chuechcon1132005-max/FreeRTOS-based-STM32-Data-Logger-with-LCD-Touch-UI/Core/Inc/main.h

#define LCD_RST_Pin GPIO_PIN_2
#define LCD_RST_GPIO_Port GPIOB
#define TP_IRQ_Pin GPIO_PIN_4
#define TP_IRQ_GPIO_Port GPIOB
#define LCD_BKL_Pin GPIO_PIN_6
#define LCD_BKL_GPIO_Port GPIOB
#define LCD_CS_Pin GPIO_PIN_7
#define LCD_CS_GPIO_Port GPIOB
#define LCD_DC_Pin GPIO_PIN_8
#define LCD_DC_GPIO_Port GPIOB
#define TP_CS_Pin GPIO_PIN_9
#define TP_CS_GPIO_Port GPIOB
