chuechcon1132005-max/FreeRTOS-based-STM32-Data-Logger-with-LCD-Touch-UI/LCD28/LCD_Driver.c

/*****************************************************************************
* | File      	:		LCD_Driver.c
* | Author      :   Waveshare team
* | Function    :   LCD_Driver driver of ST7789 & HX8347
* | Info        :
*----------------
* |	This version:   V1.2
* | Date        :   2019-08-16
* | Info        :
#
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
******************************************************************************/

#include "LCD_Driver.h"
#include "LCD_lib.h"
#include "math.h"
#include <stdlib.h>

extern SPI_HandleTypeDef hspi1;

#define LCD_SPI_BURST_PIXELS 64u

void lcd_write_byte(uint8_t chByte, uint8_t chCmd);

static void lcd_set_window_st7789(uint16_t x0, uint16_t y0, uint16_t x1, uint16_t y1)
{
	lcd_write_byte(0x2A, LCD_CMD);
	lcd_write_byte((uint8_t)(x0 >> 8), LCD_DATA);
	lcd_write_byte((uint8_t)(x0 & 0xFF), LCD_DATA);
	lcd_write_byte((uint8_t)(x1 >> 8), LCD_DATA);
	lcd_write_byte((uint8_t)(x1 & 0xFF), LCD_DATA);

	lcd_write_byte(0x2B, LCD_CMD);
	lcd_write_byte((uint8_t)(y0 >> 8), LCD_DATA);
	lcd_write_byte((uint8_t)(y0 & 0xFF), LCD_DATA);
	lcd_write_byte((uint8_t)(y1 >> 8), LCD_DATA);
	lcd_write_byte((uint8_t)(y1 & 0xFF), LCD_DATA);

	lcd_write_byte(0x2C, LCD_CMD);
}

static void lcd_push_color_st7789(uint16_t hwColor, uint32_t pixels)
{
	uint8_t burst[LCD_SPI_BURST_PIXELS * 2u];
	uint32_t i;

	for (i = 0; i < LCD_SPI_BURST_PIXELS; i++) {
		burst[(2u * i)] = (uint8_t)(hwColor >> 8);
		burst[(2u * i) + 1u] = (uint8_t)(hwColor & 0xFF);
	}

	LCD_DC_H();
	LCD_CS_L();
	while (pixels > 0u) {
		uint16_t chunk_pixels = (pixels > LCD_SPI_BURST_PIXELS) ? LCD_SPI_BURST_PIXELS : (uint16_t)pixels;
		(void)HAL_SPI_Transmit(&hspi1, burst, (uint16_t)(chunk_pixels * 2u), HAL_MAX_DELAY);
		pixels -= chunk_pixels;
	}
	LCD_CS_H();
}

/******************************************************************************
function :	initial SPI1
parameter:
******************************************************************************/
void spi_init(void)
{
	/* SPI1 is configured by MX_SPI1_Init() in main.c */
}

/******************************************************************************
function :	SPI1 send data
parameter:
send_char:	sned data
******************************************************************************/
uint8_t spi1_communication(uint8_t send_char)
{
	uint8_t rx = 0;
	if (HAL_SPI_TransmitReceive(&hspi1, &send_char, &rx, 1, HAL_MAX_DELAY) != HAL_OK) {
		return 0;
	}
	return rx;
}

/******************************************************************************
function :	write eight bits' data to LCD
parameter:
  chByte : send data
  chCmd  : command or data
******************************************************************************/
void lcd_write_byte(uint8_t chByte, uint8_t chCmd)
{
    if (chCmd) {
        LCD_DC_H();
    } else {
        LCD_DC_L();
    }
    
    LCD_CS_L();
    spi1_communication(chByte);
    LCD_CS_H();
}

/******************************************************************************
function :	write sixteen bits' data to LCD
parameter:
  chByte : send data
  chCmd  : command or data
******************************************************************************/
void lcd_write_word(uint16_t hwData)
{
    LCD_DC_H();
    LCD_CS_L();
    spi1_communication(hwData >> 8);
    spi1_communication(hwData & 0xFF);
    LCD_CS_H();
}

/******************************************************************************
function :	write data to LCD register
parameter:
     chByte : send data
		 chCmd  : command or data
******************************************************************************/
void lcd_write_command(uint8_t chRegister, uint8_t chValue)
{
	lcd_write_byte(chRegister, LCD_CMD);
	lcd_write_byte(chValue, LCD_DATA);
}

/********************************************************************************
Function Name  : initials lcd control pin 
			parameter:
********************************************************************************/
void lcd_ctrl_port_init(void)
{
	/* GPIOs are configured by MX_GPIO_Init() in main.c */
}

/******************************************************************************
Function Name  : delay
			parameter: ms
******************************************************************************/
void delay_ms(uint32_t ms)
{
	HAL_Delay(ms);
}

/******************************************************************************
Function Name  : initials lcd control pin 
			parameter:
******************************************************************************/
void lcd_init(void)
{
  lcd_ctrl_port_init();
	LCD_RST_H();
  spi_init();
	
	LCD_CS_H();
	LCD_BKL_H();
#ifdef 	ST7789_DEVICE
	LCD_RST_H();
	delay_ms(5);
	LCD_RST_L();
	delay_ms(5);
	LCD_RST_H();
	delay_ms(5);
	LCD_CS_H();
#endif
	
#ifdef HX8347D_DEVICE	
	lcd_write_command(0xEA,0x00);
	lcd_write_command(0xEB,0x20);
	lcd_write_command(0xEC,0x0C);
	lcd_write_command(0xED,0xC4);
	lcd_write_command(0xE8,0x38);
	lcd_write_command(0xE9,0x10);
	lcd_write_command(0xF1,0x01);
	lcd_write_command(0xF2,0x10);
	lcd_write_command(0x40,0x01); 
	lcd_write_command(0x41,0x00); 
	lcd_write_command(0x42,0x00); 
	lcd_write_command(0x43,0x10); 
	lcd_write_command(0x44,0x0E); 
	lcd_write_command(0x45,0x24); 
	lcd_write_command(0x46,0x04); 
	lcd_write_command(0x47,0x50); 
	lcd_write_command(0x48,0x02); 
	lcd_write_command(0x49,0x13); 
	lcd_write_command(0x4A,0x19); 
	lcd_write_command(0x4B,0x19); 
	lcd_write_command(0x4C,0x16); 
	lcd_write_command(0x50,0x1B); 
	lcd_write_command(0x51,0x31); 
	lcd_write_command(0x52,0x2F); 
	lcd_write_command(0x53,0x3F); 
	lcd_write_command(0x54,0x3F); 
	lcd_write_command(0x55,0x3E); 
	lcd_write_command(0x56,0x2F); 
	lcd_write_command(0x57,0x7B); 
	lcd_write_command(0x58,0x09); 
	lcd_write_command(0x59,0x06); 
	lcd_write_command(0x5A,0x06); 
	lcd_write_command(0x5B,0x0C); 
	lcd_write_command(0x5C,0x1D); 
	lcd_write_command(0x5D,0xCC); 
	lcd_write_command(0x1B,0x1B);
	lcd_write_command(0x1A,0x01);
	lcd_write_command(0x24,0x2F);
	lcd_write_command(0x25,0x57);
	lcd_write_command(0x23,0x88);
	lcd_write_command(0x18,0x34);
	lcd_write_command(0x19,0x01);
	lcd_write_command(0x01,0x00);
	lcd_write_command(0x1F,0x88);
	lcd_write_command(0x1F,0x80);
	lcd_write_command(0x1F,0x90);
	lcd_write_command(0x1F,0xD0);
	lcd_write_command(0x17,0x05); 
	lcd_write_command(0x36,0x02); 
	lcd_write_command(0x28,0x38);
	lcd_write_command(0x28,0x3F);
	lcd_write_command(0x16,0x18); 
	lcd_write_command(0x02,0x00);
	lcd_write_command(0x03,0x00);
	lcd_write_command(0x04,0x00);
	lcd_write_command(0x05,0xEF);
	lcd_write_command(0x06,0x00);
	lcd_write_command(0x07,0x00);
	lcd_write_command(0x08,0x01);
	lcd_write_command(0x09,0x3F);
	
#elif defined ST7789_DEVICE
	lcd_write_byte(0x11,LCD_CMD);
	delay_ms(10);
	lcd_write_command(0x36,0x00);
	lcd_write_command(0x3a,0x05);
	lcd_write_byte(0xb2,LCD_CMD);
	lcd_write_byte(0x0c,LCD_DATA);
	lcd_write_byte(0x0c,LCD_DATA);
	lcd_write_byte(0x00,LCD_DATA);
	lcd_write_byte(0x33,LCD_DATA);
	lcd_write_byte(0x33,LCD_DATA);
	lcd_write_command(0xb7,0x35);
	lcd_write_command(0xbb,0x28);
	lcd_write_command(0xc0,0x3c);
	lcd_write_command(0xc2,0x01);
	lcd_write_command(0xc3,0x0b);
	lcd_write_command(0xc4,0x20);
	lcd_write_command(0xc6,0x0f);
	lcd_write_byte(0xD0,LCD_CMD);
	lcd_write_byte(0xa4,LCD_DATA);
	lcd_write_byte(0xa1,LCD_DATA);
	lcd_write_byte(0xe0,LCD_CMD);
	lcd_write_byte(0xd0,LCD_DATA);
	lcd_write_byte(0x01,LCD_DATA);
	lcd_write_byte(0x08,LCD_DATA);
	lcd_write_byte(0x0f,LCD_DATA);
	lcd_write_byte(0x11,LCD_DATA);
	lcd_write_byte(0x2a,LCD_DATA);
	lcd_write_byte(0x36,LCD_DATA);
	lcd_write_byte(0x55,LCD_DATA);
	lcd_write_byte(0x44,LCD_DATA);
	lcd_write_byte(0x3a,LCD_DATA);
	lcd_write_byte(0x0b,LCD_DATA);
	lcd_write_byte(0x06,LCD_DATA);
	lcd_write_byte(0x11,LCD_DATA);
	lcd_write_byte(0x20,LCD_DATA);
	lcd_write_byte(0xe1,LCD_CMD);
	lcd_write_byte(0xd0,LCD_DATA);
	lcd_write_byte(0x02,LCD_DATA);
	lcd_write_byte(0x07,LCD_DATA);
	lcd_write_byte(0x0a,LCD_DATA);
	lcd_write_byte(0x0b,LCD_DATA);
	lcd_write_byte(0x18,LCD_DATA);
	lcd_write_byte(0x34,LCD_DATA);
	lcd_write_byte(0x43,LCD_DATA);
	lcd_write_byte(0x4a,LCD_DATA);
	lcd_write_byte(0x2b,LCD_DATA);
	lcd_write_byte(0x1b,LCD_DATA);
	lcd_write_byte(0x1c,LCD_DATA);
	lcd_write_byte(0x22,LCD_DATA);
	lcd_write_byte(0x1f,LCD_DATA);
	lcd_write_byte(0x29,LCD_CMD);
	lcd_write_command(0x51,0xff);
	lcd_write_command(0x55,0xB0);
#endif

	lcd_clear_screen(WHITE);
}

/******************************************************************************
Function Name  : clear lcd screen
			parameter:
				hwColor: background color
******************************************************************************/
void lcd_clear_screen(uint16_t hwColor)
{
	uint32_t i, wCount = LCD_WIDTH;
	wCount *= LCD_HEIGHT;

#ifdef ST7789_DEVICE
	lcd_set_window_st7789(0u, 0u, (uint16_t)(LCD_WIDTH - 1u), (uint16_t)(LCD_HEIGHT - 1u));
	lcd_push_color_st7789(hwColor, wCount);
	return;
#endif

#ifdef HX8347D_DEVICE
	lcd_set_cursor(0, 0);
	lcd_write_byte(0x22, LCD_CMD);
#endif
	LCD_CS_L();	
	LCD_DC_H();
	for(i=0;i<wCount;i++){
#ifdef HX8347D_DEVICE
//		spi1_communication((uint8_t)(hwColor&0xff));
//		spi1_communication(hwColor>>8);
		
		spi1_communication(hwColor>>8);
		spi1_communication((uint8_t)(hwColor&0xff));
#elif defined ST7789_DEVICE
		spi1_communication(hwColor>>8);
		spi1_communication((uint8_t)(hwColor&0xff));
#endif
	}
	LCD_CS_H();	
}

/******************************************************************************
Function Name  : set lcd cursor
			parameter:
				 hwXpos: x axis position
				 hwYpos: y axis position
******************************************************************************/
void lcd_set_cursor(uint16_t hwXpos, uint16_t hwYpos)
{
	if (hwXpos >= LCD_WIDTH || hwYpos >= LCD_HEIGHT) {
		return;
	}
#ifdef HX8347D_DEVICE
	lcd_write_command(0x02, hwXpos >> 8);
	lcd_write_command(0x03, hwXpos & 0xFF); 
	lcd_write_command(0x06, hwYpos >> 8);
	lcd_write_command(0x07, hwYpos & 0xFF); 
#elif defined ST7789_DEVICE
	lcd_write_byte(0x2A,LCD_CMD);
	lcd_write_byte(0x00,LCD_DATA);
	lcd_write_byte(hwXpos,LCD_DATA);
	lcd_write_byte(0x2B,LCD_CMD);
	lcd_write_byte((hwYpos>>8)&0xff,LCD_DATA);
	lcd_write_byte(hwYpos&0xff,LCD_DATA);	
#endif
}

/******************************************************************************
Function Name  : lcd display char
			parameter:
				 hwXpos: x axis position
				 hwYpos: y axis position
				  chChr: display character
				 chSize: character size
			  hwColor: character color
******************************************************************************/
void lcd_display_char(	 uint16_t hwXpos, 
                         uint16_t hwYpos, 
                         uint8_t chChr,   
                         uint8_t chSize,  
                         uint16_t hwColor)
{      	
	uint8_t i, j, chTemp = 0;
	uint16_t hwYpos0 = hwYpos, hwColorVal = 0;

	if (hwXpos >= LCD_WIDTH || hwYpos >= LCD_HEIGHT) {
		return;
	}
#ifdef HX8347D_DEVICE
	
#elif defined ST7789_DEVICE
	lcd_write_byte(0x2A,LCD_CMD);
	lcd_write_byte(0x00,LCD_DATA);
	lcd_write_byte(hwXpos,LCD_DATA);
	lcd_write_byte((hwXpos) >> 8,LCD_DATA);
	lcd_write_byte((hwXpos) & 0xFF,LCD_DATA);

	lcd_write_byte(0x2B,LCD_CMD);
	lcd_write_byte(hwYpos >> 8,LCD_DATA);
	lcd_write_byte(hwYpos & 0xFF,LCD_DATA);
	lcd_write_byte((hwYpos) >> 8,LCD_DATA);
	lcd_write_byte((hwYpos) & 0xFF,LCD_DATA);
	lcd_write_byte(0x2C, LCD_CMD);
#endif
    for (i = 0; i < chSize; i ++) {
				if (FONT_1206 == chSize) {
					chTemp = c_chFont1206[chChr - 0x20][i];  
				}
				else if (FONT_1608 == chSize) { 
					chTemp = c_chFont1608[chChr - 0x20][i];
				}			
        for (j = 0; j < 8; j ++) {
					if (chTemp & 0x80) {
						hwColorVal = hwColor;
						lcd_draw_dot(hwXpos, hwYpos, hwColorVal);
					}			
					chTemp <<= 1;
					hwYpos ++;
					if ((hwYpos - hwYpos0) == chSize) {
						hwYpos = hwYpos0;
						hwXpos ++;
						break;
					}
				}  	 
    } 
}
/******************************************************************************
Function Name  : lcd display string
			parameter:
				 hwXpos: x axis position
				 hwYpos: y axis position
		  pchString: display string
				 chSize: string size
			  hwColor: string color
******************************************************************************/
void lcd_display_string(	uint16_t hwXpos,uint16_t hwYpos,
													const uint8_t *pchString,
													uint8_t chSize,uint16_t hwColor)
{

	if (hwXpos >= LCD_WIDTH || hwYpos >= LCD_HEIGHT) {
		return;
	}
	
    while (*pchString != '\0') {       
        if (hwXpos > (LCD_WIDTH - chSize / 2)) {
					hwXpos = 0;
					hwYpos += chSize;
					if (hwYpos > (LCD_HEIGHT - chSize)) {
						hwYpos = hwXpos = 0;
						lcd_clear_screen(0x00);
					}
				}
		
        lcd_display_char(hwXpos, hwYpos, (uint8_t)*pchString, chSize, hwColor);
        hwXpos += chSize / 2;
        pchString ++;
    } 
}

/******************************************************************************
Function Name  : lcd display chinese character
			parameter:
						 gb:	which character in GB2312[][32] 
	  color_front:	character color
				 hwXpos: x axis position
				 hwYpos: y axis position
******************************************************************************/
void lcd_display_GB2312(  uint8_t gb, uint16_t color_front, 
													uint16_t postion_x,uint16_t postion_y )
{
	uint8_t i, j,chTemp;
	uint16_t hwYpos0 = postion_y, hwColorVal = 0;
	
	if (postion_x >= LCD_WIDTH || postion_y >= LCD_HEIGHT) {
		return;
	}
	
	for (i = 0; i < 32; i++) {
		chTemp = GB2312[gb][i];
		for (j = 0; j < 8; j++) {
			if (chTemp & 0x80) {
					hwColorVal = color_front;
				if(i<15)
					lcd_draw_dot(postion_x, postion_y, hwColorVal);
				else
					lcd_draw_dot(postion_x-16, postion_y+8, hwColorVal);
			}
			chTemp <<= 1;
			postion_y ++;
			if ((postion_y - hwYpos0) == 8) {
				postion_y = hwYpos0;
				postion_x ++;
				break;
			}
		}
	}
}

/******************************************************************************
Function Name  : lcd draw a dot
			parameter:
				 hwXpos: x axis position
				 hwYpos: y axis position
				hwColor:	dot color
******************************************************************************/
void lcd_draw_dot(uint16_t hwXpos, uint16_t hwYpos, uint16_t hwColor)
{
	if (hwXpos >= LCD_WIDTH || hwYpos >= LCD_HEIGHT) {
		return;
	}
	lcd_set_cursor(hwXpos, hwYpos);
#ifdef HX8347D_DEVICE
	lcd_write_byte(0x22, LCD_CMD);
#elif defined ST7789_DEVICE
	lcd_write_byte(0x2C, LCD_CMD);
#endif
	lcd_write_word(hwColor);

}

/******************************************************************************
Function Name  : lcd draw a big dot
			parameter:
	  color_front:	dot color
		  	 hwXpos: x axis position
				h wYpos: y axis position
******************************************************************************/
void lcd_draw_bigdot(unsigned long color_front,
					 unsigned long x,unsigned long y )
{
    lcd_draw_dot(color_front,x,y);
    lcd_draw_dot(color_front,x,y+1);
    lcd_draw_dot(color_front,x,y-1);

    lcd_draw_dot(color_front,x+1,y);
    lcd_draw_dot(color_front,x+1,y+1);
    lcd_draw_dot(color_front,x+1,y-1);
    
    lcd_draw_dot(color_front,x-1,y);    
    lcd_draw_dot(color_front,x-1,y+1);
    lcd_draw_dot(color_front,x-1,y-1);
    
}

/******************************************************************************
Function Name  : calculate N power
			parameter:
						 m :	valure
					   n :  exponent
******************************************************************************/
static uint32_t _pow(uint8_t m, uint8_t n)
{
	uint32_t result = 1;
	
	while(n --) result *= m;    
	return result;
}

/******************************************************************************
Function Name  : lcd display number
			parameter:
				 hwXpos: x axis position
				 hwYpos: y axis position
				  chNum: number
				  chLen: number length  
				 chSize: number size
				hwColor: number color
******************************************************************************/
void lcd_display_num(			uint16_t hwXpos,  uint16_t hwYpos, 
						 unsigned long chNum,  uint8_t chLen,   
                          uint8_t chSize,  uint16_t hwColor)
{         	
	uint8_t i;
	uint8_t chTemp, chShow = 0;

	if (hwXpos >= LCD_WIDTH || hwYpos >= LCD_HEIGHT) {
		return;
	}
	
	for(i = 0; i < chLen; i ++) {
		chTemp = (chNum / _pow(10, chLen - i - 1)) % 10;
		if(chShow == 0 && i < (chLen - 1)) {
			if(chTemp == 0) {
				lcd_display_char(hwXpos + (chSize / 2) * i, hwYpos, ' ', chSize, hwColor);
				continue;
			} else {
				chShow = 1;
			}	 
		}
	 	lcd_display_char(hwXpos + (chSize / 2) * i, hwYpos, chTemp + '0', chSize, hwColor); 
	}
} 

/******************************************************************************
Function Name  : lcd draw a line
			parameter:
				hwXpos0: x axis start position
				hwYpos0: y axis start position
				hwXpos1: x axis end position
				hwYpos1: y axis end position
				hwColor: line color
******************************************************************************/
void lcd_draw_line(		uint16_t hwXpos0, uint16_t hwYpos0, 
                      uint16_t hwXpos1, uint16_t hwYpos1, 
                      uint16_t hwColor) 
{
	int x = hwXpos1 - hwXpos0;
	int y = hwYpos1 - hwYpos0;
	int dx = abs(x), sx = hwXpos0 < hwXpos1 ? 1 : -1;
	int dy = -abs(y), sy = hwYpos0 < hwYpos1 ? 1 : -1;
	int err = dx + dy, e2;

	if (hwXpos0 >= LCD_WIDTH || hwYpos0 >= LCD_HEIGHT || hwXpos1 >= LCD_WIDTH || hwYpos1 >= LCD_HEIGHT) {
		return;
	}
    
    for (;;){
        lcd_draw_dot(hwXpos0, hwYpos0 , hwColor);
        e2 = 2 * err;
        if (e2 >= dy) {     
            if (hwXpos0 == hwXpos1) break;
            err += dy; hwXpos0 += sx;
        }
        if (e2 <= dx) {
            if (hwYpos0 == hwYpos1) break;
            err += dx; hwYpos0 += sy;
        }
    }
}

/******************************************************************************
Function Name  : lcd draw a circle
			parameter:
				hwXpos: x axis  position
				hwYpos: y axis  position
			 hwRadius: circle radius
				hwColor: cirlce color
******************************************************************************/
void lcd_draw_circle(		uint16_t hwXpos, uint16_t hwYpos, 
                        uint16_t hwRadius,uint16_t hwColor) 
{
	int x = -hwRadius, y = 0, err = 2 - 2 * hwRadius, e2;

	if (hwXpos >= LCD_WIDTH || hwYpos >= LCD_HEIGHT) {
		return;
	}
	
    do {
        lcd_draw_dot(hwXpos - x, hwYpos + y, hwColor);
        lcd_draw_dot(hwXpos + x, hwYpos + y, hwColor);
        lcd_draw_dot(hwXpos + x, hwYpos - y, hwColor);
        lcd_draw_dot(hwXpos - x, hwYpos - y, hwColor);
        e2 = err;
        if (e2 <= y) {
            err += ++ y * 2 + 1;
            if(-x == y && e2 <= x) e2 = 0;
        }
        if(e2 > x) err += ++ x * 2 + 1;
    } while(x <= 0);
}

/******************************************************************************
Function Name  :  fill a rectangle on lcd
			parameter:
				 hwXpos: x axis  position
				 hwYpos: y axis  position
			  hwWidth: rectangle width
			 hwHeight: rectangle height
			  hwColor: rectangle color
******************************************************************************/
void lcd_fill_rect(uint16_t hwXpos, 
                   uint16_t hwYpos, uint16_t hwWidth,
                   uint16_t hwHeight,uint16_t hwColor)
{
	uint16_t i, j;
	uint16_t x1, y1;

	if (hwXpos >= LCD_WIDTH || hwYpos >= LCD_HEIGHT) {
		return;
	}

	if ((hwWidth == 0u) || (hwHeight == 0u)) {
		return;
	}

	x1 = MIN((uint16_t)(hwXpos + hwWidth - 1u), (uint16_t)(LCD_WIDTH - 1u));
	y1 = MIN((uint16_t)(hwYpos + hwHeight - 1u), (uint16_t)(LCD_HEIGHT - 1u));

#ifdef ST7789_DEVICE
	lcd_set_window_st7789(hwXpos, hwYpos, x1, y1);
	lcd_push_color_st7789(hwColor, (uint32_t)(x1 - hwXpos + 1u) * (uint32_t)(y1 - hwYpos + 1u));
	return;
#endif
	
	for(i = 0; i < hwHeight; i ++){
		for(j = 0; j < hwWidth; j ++){
			lcd_draw_dot(hwXpos + j, hwYpos + i, hwColor);
		}
	}
}

/******************************************************************************
Function Name  : draw a vertical line at the specified position on lcd
			parameter:
				 hwXpos: x axis  position
				 hwYpos: y axis  position
			 hwHeight: line height
			  hwColor: vertical linc color
******************************************************************************/
void lcd_draw_v_line(		uint16_t hwXpos,uint16_t hwYpos, 
                        uint16_t hwHeight,uint16_t hwColor)  
{	
	uint16_t i, y1 = MIN(hwYpos + hwHeight, LCD_HEIGHT - 1);

	if (hwXpos >= LCD_WIDTH || hwYpos >= LCD_HEIGHT) {
		return;
	}

#ifdef ST7789_DEVICE
	if (y1 > hwYpos) {
		lcd_fill_rect(hwXpos, hwYpos, 1u, (uint16_t)(y1 - hwYpos), hwColor);
	}
	return;
#endif
	
    for (i = hwYpos; i < y1; i ++) {
        lcd_draw_dot(hwXpos, i, hwColor);
    }
}

/******************************************************************************
Function Name  : draw a horizonal line at the specified position on lcd
			parameter:
				 hwXpos: x axis  position
				 hwYpos: y axis  position
			  hwWidth: line width
			  hwColor: horizonal linc color
******************************************************************************/
void lcd_draw_h_line(		uint16_t hwXpos, uint16_t hwYpos,  
                        uint16_t hwWidth,uint16_t hwColor)
{	
	uint16_t i, x1 = MIN(hwXpos + hwWidth, LCD_WIDTH - 1);

	if (hwXpos >= LCD_WIDTH || hwYpos >= LCD_HEIGHT) {
		return;
	}

#ifdef ST7789_DEVICE
	if (x1 > hwXpos) {
		lcd_fill_rect(hwXpos, hwYpos, (uint16_t)(x1 - hwXpos), 1u, hwColor);
	}
	return;
#endif
	
    for (i = hwXpos; i < x1; i ++) {
        lcd_draw_dot(i, hwYpos, hwColor);
    }
}

/******************************************************************************
Function Name  : draw a rectangle on lcd
			parameter:
				 hwXpos: x axis  position
				 hwYpos: y axis  position
			  hwWidth: rectangle width
			 hwHeight: rectangle height
			  hwColor: rectangle color
******************************************************************************/
void lcd_draw_rect(		uint16_t hwXpos,  
                      uint16_t hwYpos,uint16_t hwWidth, 
                      uint16_t hwHeight,uint16_t hwColor) 
{
	if (hwXpos >= LCD_WIDTH || hwYpos >= LCD_HEIGHT) {
		return;
	}

	lcd_draw_h_line(hwXpos, hwYpos, hwWidth, hwColor);
	lcd_draw_h_line(hwXpos, hwYpos + hwHeight, hwWidth, hwColor);
	lcd_draw_v_line(hwXpos, hwYpos, hwHeight, hwColor);
	lcd_draw_v_line(hwXpos + hwWidth, hwYpos, hwHeight + 1, hwColor);
}

/******************************************************************************
Function Name  : clear rectangle on lcd
			parameter:
				 hwXpos: x axis  position
				 hwYpos: y axis  position
			  hwXpos1: rectangle width
			  hwYpos1: rectangle height
	  color_front: rectangle color
******************************************************************************/
void lcd_clear_Rect(	unsigned long color_front, 
											unsigned long hwXpos,unsigned long hwYpos, 
											unsigned long hwXpos1,unsigned long hwYpos1)
{
	uint16_t i, j;

	if (hwXpos1 >= LCD_WIDTH || hwYpos1 >= LCD_HEIGHT) {
		return;
	}

#ifdef ST7789_DEVICE
	if ((hwXpos1 >= hwXpos) && (hwYpos1 >= hwYpos)) {
		lcd_fill_rect((uint16_t)hwXpos,
					  (uint16_t)hwYpos,
					  (uint16_t)(hwXpos1 - hwXpos + 1u),
					  (uint16_t)(hwYpos1 - hwYpos + 1u),
					  (uint16_t)color_front);
	}
	return;
#endif
	
	for(i = 0; i < hwYpos1-hwYpos+1; i ++){
		for(j = 0; j < hwXpos1-hwXpos+1; j ++){
			lcd_draw_dot(hwXpos + j, hwYpos + i, color_front);
		}
	}
}

/*-------------------------------END OF FILE-------------------------------*/
