chuechcon1132005-max/FreeRTOS-based-STM32-Data-Logger-with-LCD-Touch-UI/LCD28/LCD_lib.c

/*****************************************************************************
* File Name          : LCD_lib.c
* Author             : Librae
* Last Modified Date : 07/17/2010
* Description        : This file provides the LCD library.

******************************************************************************/

/* Includes -----------------------------------------------------------------*/
#include "LCD_lib.h"

/* Private typedef ----------------------------------------------------------*/
/* Private define -----------------------------------------------------------*/
/* Private macro ------------------------------------------------------------*/
/* Private variables --------------------------------------------------------*/

const unsigned char c_chFont1206[95][12] = {
{0x00,0x00,0x00,0x00,0x00,0x00,0x00,0x00,0x00,0x00,0x00,0x00},/*" ",0*/
{0x00,0x00,0x00,0x00,0x3F,0x40,0x00,0x00,0x00,0x00,0x00,0x00},/*"!",1*/
{0x00,0x00,0x30,0x00,0x40,0x00,0x30,0x00,0x40,0x00,0x00,0x00},/*""",2*/
{0x09,0x00,0x0B,0xC0,0x3D,0x00,0x0B,0xC0,0x3D,0x00,0x09,0x00},/*"#",3*/
{0x18,0xC0,0x24,0x40,0x7F,0xE0,0x22,0x40,0x31,0x80,0x00,0x00},/*"$",4*/
{0x18,0x00,0x24,0xC0,0x1B,0x00,0x0D,0x80,0x32,0x40,0x01,0x80},/*"%",5*/
{0x03,0x80,0x1C,0x40,0x27,0x40,0x1C,0x80,0x07,0x40,0x00,0x40},/*"&",6*/
{0x10,0x00,0x60,0x00,0x00,0x00,0x00,0x00,0x00,0x00,0x00,0x00},/*"'",7*/
{0x00,0x00,0x00,0x00,0x00,0x00,0x1F,0x80,0x20,0x40,0x40,0x20},/*"(",8*/
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
0x02,0x0C,0x00,0xEE,0x01,0x81,0x11,0x4D,0x21,0xC1,0x01,0x07,0x00,0x88,0x06,0x00},
};

/* Private function prototypes ----------------------------------------------*/

/* Private functions --------------------------------------------------------*/
