chuechcon1132005-max/FreeRTOS-based-STM32-Data-Logger-with-LCD-Touch-UI/LCD28/LCD_lib.h

/************************ (C) COPYLEFT 2010 Leafgrass *************************

* File Name          : LCD_lib.h
* Author             : Librae
* Last Modified Date : 07/17/2010
* Description        : This file provides the LTM022A69B LCD library.

******************************************************************************/

/* Define to prevent recursive inclusion ------------------------------------*/
#ifndef __LCD_LIB_H__
#define __LCD_LIB_H__

/* Includes -----------------------------------------------------------------*/

/* Exported types -----------------------------------------------------------*/

/* Exported variables -------------------------------------------------------*/
extern const unsigned char c_chFont1206[95][12];
extern const unsigned char c_chFont1608[95][16];
extern const unsigned char GB2312[][32];


/* Exported constants -------------------------------------------------------*/

/* Exported macro -----------------------------------------------------------*/

/* Exported functions ------------------------------------------------------ */

#endif

/************************ (C) COPYLEFT 2010 Leafgrass ************************/
